dgm91-pro/Attiny85_NFC_MULTI_TAG/Budget/HackClub-8pin.csv

Le pays d'origine peut être différent au moment de l'expédition.
Les informations HTSUS et ECCN affichées sont fournies à titre informatif uniquement et ne constituent pas une représentation ou une garantie quant à l'exactitude ou la fiabilité de ces classifications. Toutes les informations sont fournies « en l'état » et sont susceptibles d'être modifiées sans préavis. L'utilisation des informations fournies ne pourra donner lieu à un recours envers Digi-Key et se fait aux risques de l'utilisateur.
Index | Référence fabricant | Nom du fabricant | Description | Délai d'approvisionnement | % d'attrition | Quantité demandée 1 | Quantité par pack 1 | Type de conditionnement 1 | Numéro de référence Digi-Key 1 | Prix unitaire 1 | Prix calculé 1 | Quantité de commande minimum 1 | Référence client | Numéro de référence demandé | Semaines d'approvisionnement | Fiche technique | Identificateur de référence | Tarif d'importation US | Note | Statut du composant | Statut RoHS | Statut REACH | Niveau de sensibilité à l'humidité (MSL) | ECCN | HTSUS | Pays d'origine | Informations environnementales | Numéros de référence d'origine | Unité de mesure | Image | Notes sur le produit
1 | APTF1616LSEEZGKQBKC | Kingbright | LED RGB CLEAR 4SMD |  |  | 1 | 1 | Cut Tape (CT) | 754-1972-1-ND | 0,85000 | 0,85 $ | 1 |  | 754-1972-2-ND | 7 | https://www.KingbrightUSA.com/images/catalog/SPEC/APTF1616LSEEZGKQBKC.pdf |  | '- |  | Active | Conforme à RoHS 3 | REACH - Non concerné | 3 (168 heures) | EAR99 | 8541.41.0000 | China | https://www.KingbrightUSA.com/webimages/certificate/Kingbright%20RoHS%20CoC.PDF|https://www.kingbrightusa.com/webimages/certificate/REACH.pdf | 754-1972-2-ND | Each | https://mm.digikey.com/Volume0/opasdata/d220001/medias/images/6348/MFG_APTF1616.jpg
2 | RMCF0603FT33R0 | Stackpole Electronics Inc | RES 33 OHM 1% 1/10W 0603 |  |  | 1 | 1 | Cut Tape (CT) | RMCF0603FT33R0CT-ND | 0,10000 | 0,10 $ | 1 |  | RMCF0603FT33R0TR-ND | 21 | https://www.seielect.com/catalog/SEI-RMCF_RMCP.pdf |  | '- |  | Active | Conforme à RoHS 3 | REACH - Non concerné | 1 (illimité) | EAR99 | 8533.21.0030 | Taiwan | https://www.seielect.com/catalog/SEI-RoHS_Compliance_Status.pdf|https://www.seielect.com/catalog/reach.pdf|https://www.seielect.com/catalog/sei-coc%20prop%2065.pdf | RMCF0603FT33R0TR-ND | Each | https://mm.digikey.com/Volume0/opasdata/d220001/derivates/6/003/238/576/MFG_RMCF_series_web%28640x640%29.jpg
3 | RMCF0603FT220R | Stackpole Electronics Inc | RES 220 OHM 1% 1/10W 0603 |  |  | 1 | 1 | Cut Tape (CT) | RMCF0603FT220RCT-ND | 0,10000 | 0,10 $ | 1 |  | RMCF0603FT220RTR-ND | 22 | https://www.seielect.com/catalog/SEI-RMCF_RMCP.pdf |  | '- |  | Active | Conforme à RoHS 3 | REACH - Non concerné | 1 (illimité) | EAR99 | 8533.21.0030 | Taiwan | https://www.seielect.com/catalog/SEI-RoHS_Compliance_Status.pdf|https://www.seielect.com/catalog/reach.pdf|https://www.seielect.com/catalog/sei-coc%20prop%2065.pdf | RMCF0603FT220RTR-ND | Each | https://mm.digikey.com/Volume0/opasdata/d220001/derivates/6/003/238/576/MFG_RMCF_series_web%28640x640%29.jpg
4 | RMCF0603FT470R | Stackpole Electronics Inc | RES 470 OHM 1% 1/10W 0603 |  |  | 1 | 1 | Cut Tape (CT) | RMCF0603FT470RCT-ND | 0,11000 | 0,11 $ | 1 |  | RMCF0603FT470RTR-ND | 22 | https://www.seielect.com/catalog/SEI-RMCF_RMCP.pdf |  | '- |  | Active | Conforme à RoHS 3 | REACH - Non concerné | 1 (illimité) | EAR99 | 8533.21.0030 | Taiwan | https://www.seielect.com/catalog/SEI-RoHS_Compliance_Status.pdf|https://www.seielect.com/catalog/reach.pdf|https://www.seielect.com/catalog/sei-coc%20prop%2065.pdf | RMCF0603FT470RTR-ND | Each | https://mm.digikey.com/Volume0/opasdata/d220001/derivates/6/003/121/213/cut-tape-render_web%28640x640%29.jpg
5 | RMCF0603FT10K0 | Stackpole Electronics Inc | RES 10K OHM 1% 1/10W 0603 |  |  | 3 | 3 | Cut Tape (CT) | RMCF0603FT10K0CT-ND | 0,11000 | 0,33 $ | 1 |  | RMCF0603FT10K0TR-ND | 22 | https://www.seielect.com/catalog/SEI-RMCF_RMCP.pdf |  | '- |  | Active | Conforme à RoHS 3 | REACH - Non concerné | 1 (illimité) | EAR99 | 8533.21.0030 | Taiwan | https://www.seielect.com/catalog/SEI-RoHS_Compliance_Status.pdf|https://www.seielect.com/catalog/reach.pdf|https://www.seielect.com/catalog/sei-coc%20prop%2065.pdf | RMCF0603FT10K0TR-ND | Each | https://mm.digikey.com/Volume0/opasdata/d220001/derivates/6/003/121/213/cut-tape-render_web%28640x640%29.jpg
6 | ATTINY85V-10SU | Microchip Technology | IC MCU 8BIT 8KB FLASH 8SOIC |  |  | 1 | 1 | Tube | ATTINY85V-10SU-ND | 1,50000 | 1,50 $ | 1 |  | ATTINY85V-10SU-ND | 4 | https://ww1.microchip.com/downloads/en/DeviceDoc/Atmel-2586-AVR-8-bit-Microcontroller-ATtiny25-ATtiny45-ATtiny85_Datasheet-Summary.pdf |  | '- |  | Active | Conforme à RoHS 3 | REACH - Non concerné | 3 (168 heures) | EAR99 | 8542.31.0015 | Thailand | https://ww1.microchip.com/downloads/aemDocuments/documents/corporate-responsibilty/environmental/product-regulatory-information/Semiconductor_EnvCoC.pdf|https://ww1.microchip.com/downloads/aemDocuments/documents/corporate-responsibilty/environmental/product-regulatory-information/Microchip_REACH_Statement.pdf | ATTINY85V-10SU-ND | Each | https://mm.digikey.com/Volume0/opasdata/d220001/medias/images/4849/313_8-SOIC.jpg
7 | PTS526SM15SMTR2 LFS | C&K | SWITCH TACTILE SPST-NO 0.05A 12V |  |  | 1 | 1 | Cut Tape (CT) | CKN12220-1-ND | 0,16000 | 0,16 $ | 1 |  | CKN12220-1-ND | 12 | https://www.littelfuse.com/assetdocs/littelfuse-c-k-tactile-pts526-series-datasheet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 |  | '- |  | Active | Conforme à RoHS 3 | REACH - Non concerné | 1 (illimité) | EAR99 | 8536.50.9031 | China |  | CKN12220-1-ND | Each | https://mm.digikey.com/Volume0/opasdata/d220001/medias/images/308/PTS526-SK15-SMTR2-LFS.JPG
8 | ST25DV04KC-IE6S3 | STMicroelectronics | DYNAMIC NFC/RFID TAG IC WITH 4-K |  |  | 1 | 1 | Cut Tape (CT) | 497-ST25DV04KC-IE6S3CT-ND | 1,05000 | 1,05 $ | 1 |  | 497-ST25DV04KC-IE6S3CT-ND | 22 | https://www.st.com/resource/en/datasheet/st25dv04kc.pdf |  | '- |  | Active | Conforme à RoHS 3 | REACH - Non concerné | 1 (illimité) | EAR99 | 8542.39.0070 | France |  | 497-ST25DV04KC-IE6S3CT-ND | Each | https://mm.digikey.com/Volume0/opasdata/d220001/derivates/6/300/456/795/497%7E8SOIC-3.9%7E%7E8_web%28640x640%29.jpg
9 | CL10B104KO8NNNC | Samsung Electro-Mechanics | CAP CER 0.1UF 16V X7R 0603 | Date estimée de mise en stock non disponible en raison des conditions de marché du produit |  | 2 | 2 | Cut Tape (CT) | 1276-1005-1-ND | 0,10000 | 0,20 $ | 1 |  | 1276-1005-1-ND | 61 | https://mm.digikey.com/Volume0/opasdata/d220001/medias/docus/609/CL10B104KO8NNNC_Spec.pdf |  | '- |  | Active | Conforme à RoHS 3 | REACH - Non concerné | 1 (illimité) | EAR99 | 8532.24.0020 | Philippines | https://www.samsungsem.com/files/fileDown.do?key=ed1dfdfa-645e-4252-b707-17f9b1502dd1|https://www.samsungsem.com/global/support/certificate/product-stewardship.do | 1276-1005-1-ND | Each | https://mm.digikey.com/Volume0/opasdata/d220001/medias/images/2537/Ceramic-Capacitor-CL-Series.jpg
10 | CL21B106KOQNNNE | Samsung Electro-Mechanics | CAP CER 10UF 16V X7R 0805 | 1 attendus en stock au 22/04/2027 |  | 1 | 1 | Cut Tape (CT) | 1276-2872-1-ND | 0,27000 | 0,27 $ | 1 |  | 1276-2872-1-ND | 61 | https://mm.digikey.com/Volume0/opasdata/d220001/medias/docus/926/CL_Series_MLCC_ds.pdf |  | '- |  | Active | Conforme à RoHS 3 | REACH - Non concerné | 1 (illimité) | EAR99 | 8532.24.0020 | Philippines | https://www.samsungsem.com/files/fileDown.do?key=ed1dfdfa-645e-4252-b707-17f9b1502dd1|https://www.samsungsem.com/global/support/certificate/product-stewardship.do | 1276-2872-1-ND | Each | https://mm.digikey.com/Volume0/opasdata/d220001/medias/images/2537/Ceramic-Capacitor-CL-Series.jpg
11 | BC2032-E2 | MPD (Memory Protection Devices) | BATTERY HOLDER COIN 20MM PC PIN |  |  | 1 | 1 | Bulk | BC2032-E2-ND | 1,13000 | 1,13 $ | 1 |  | BC2032-E2-ND | 20 | https://www.memoryprotectiondevices.com/datasheets/BC2032-E2/BC2032-E2-datasheet.pdf |  | '- |  | Active | Conforme à RoHS | REACH - Non concerné | 1 (illimité) | EAR99 | 8536.69.4040 | China |  | BC2032-E2-ND | Each | https://mm.digikey.com/Volume0/opasdata/d220001/derivates/6/003/265/300/BC2032-E2_web%28640x640%29.jpg
