dgm91-pro/Attiny85_NFC_MULTI_TAG/KiCad/tag.kicad_pcb

## KiCad design KiCad/tag.kicad_pcb (2026-10-27)

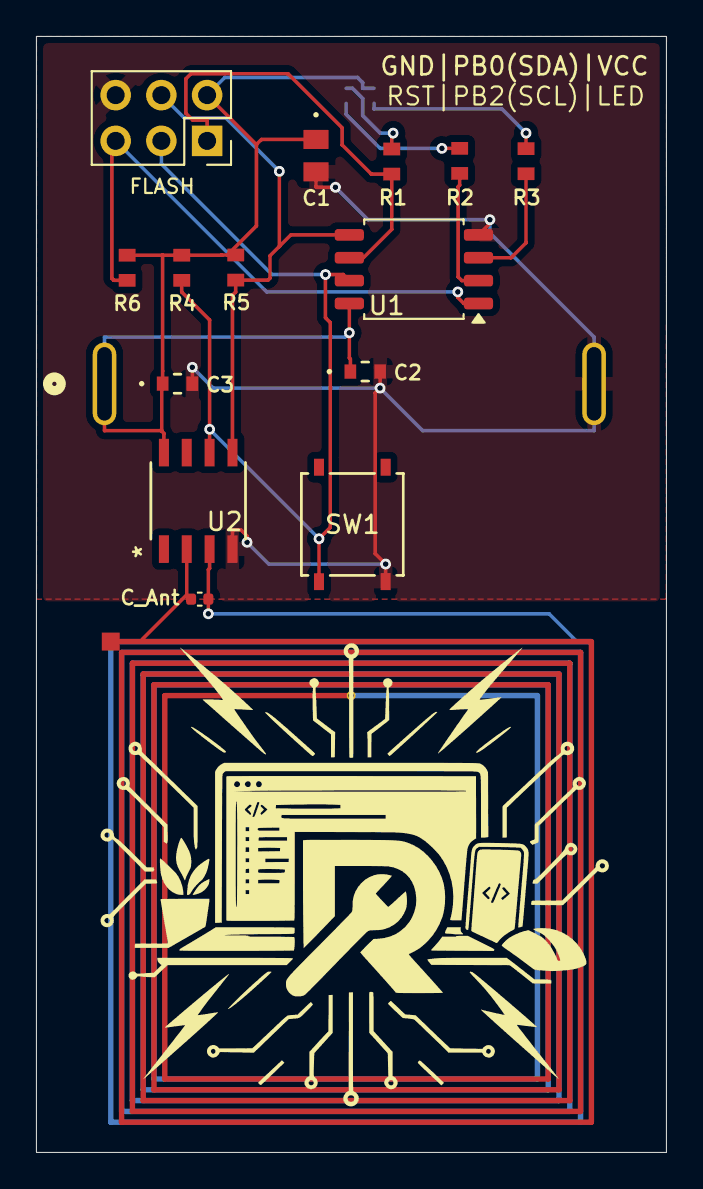
[picture p1: board tag.kicad_pcb from above]

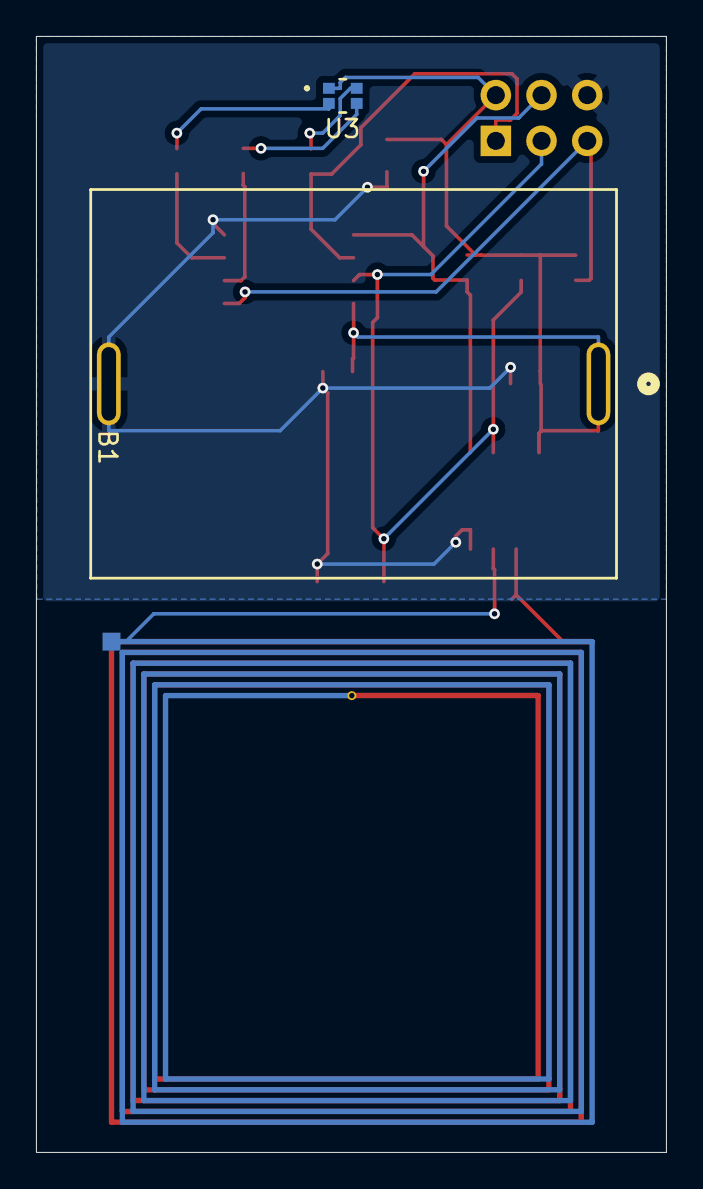
[picture p2: board tag.kicad_pcb from below]

Board: 2 copper layers, 35.0 x 62.0 mm, 17 parts (2 on the bottom side), 13 nets.

Parts:
B1: BC2032-E2; BC2032-E2_MPD
C1: CL21B106KOQNNNE; CAP_CL21B106KOQNNNE_SAM
C2, C3: CL10B104KO8NNNC; CAP_CL10_SAM
C_Ant: C; C_0402_1005Metric
FLASH: Conn_02x03_Counter_Clockwise; PinSocket_2x03_P2.54mm_Vertical
L1: L; ANT_Spiral_v3
R1: RMCF0603FT470R; STA_RMCF0603_STP
R2: RMCF0603FT220R; STA_RMCF0603_STP
R3: RMCF0603FT33R0; STA_RMCF0603_STP
R4, R5, R6: RMCF0603FT10K0; STA_RMCF0603_STP
SW1: PTS526 SM15 SMTR2 LFS; SON4_PTS526 SM15 SMTR2 LFS_CNK
U1: ATtiny85V-10S; SOIC-8_5.3x5.3mm_P1.27mm
U2: ST25DV04KC-IE6S3; SO-8_STM
U3: APTF1616LSEEZGKQBKC; SON4_APTF1616LSEEZGKQBKC_KNB_fixed

Connections:
GND: B1.2, C1.2, C2.2, C3.2, FLASH.6, SW1.3, U1.4 (GND), U2.4 (VSS)
unnamed: FLASH.1, R1.1, U1.6 (PB1)
unnamed: FLASH.3, R4.1, SW1.1, U1.7 (PB2), U2.6 (SCL)
unnamed: FLASH.4, R5.1, U1.5 (AREF/PB0), U2.5 (SDA)
unnamed: FLASH.5, R6.2, U1.1 (~RESET/PB5)
unnamed: R2.1, U1.2 (XTAL1/PB3)
unnamed: R3.1, U1.3 (XTAL2/PB4)
unnamed: C_Ant.1, L1.1, U2.2 (AC0)
unnamed: C_Ant.2, L1.2, U2.3 (AC1)
unnamed: R3.2, U3.4 (BLUE)
unnamed: R2.2, U3.3 (GREEN)
unnamed: R1.2, U3.2 (RED)
VCC: B1.1, C1.1, C2.1, C3.1, FLASH.2, R4.2, R5.2, R6.1, U1.8 (VCC), U2.8 (VCC), U3.1 (VCC)
